RolandWa/logicanalyzer/(list of files, cad)

Other CAD files:
Electronics/LogicAnalyzer/LogicAnalyzer_Roland/1591ATBU.dwg
