RolandWa/logicanalyzer/Electronics/LogicAnalyzer/LogicAnalyzer_Roland/LogicAnalyzer_Roland.kicad_pcb

## KiCad design Electronics/LogicAnalyzer/LogicAnalyzer_Roland/LogicAnalyzer_Roland.kicad_pcb (2025-03-13)

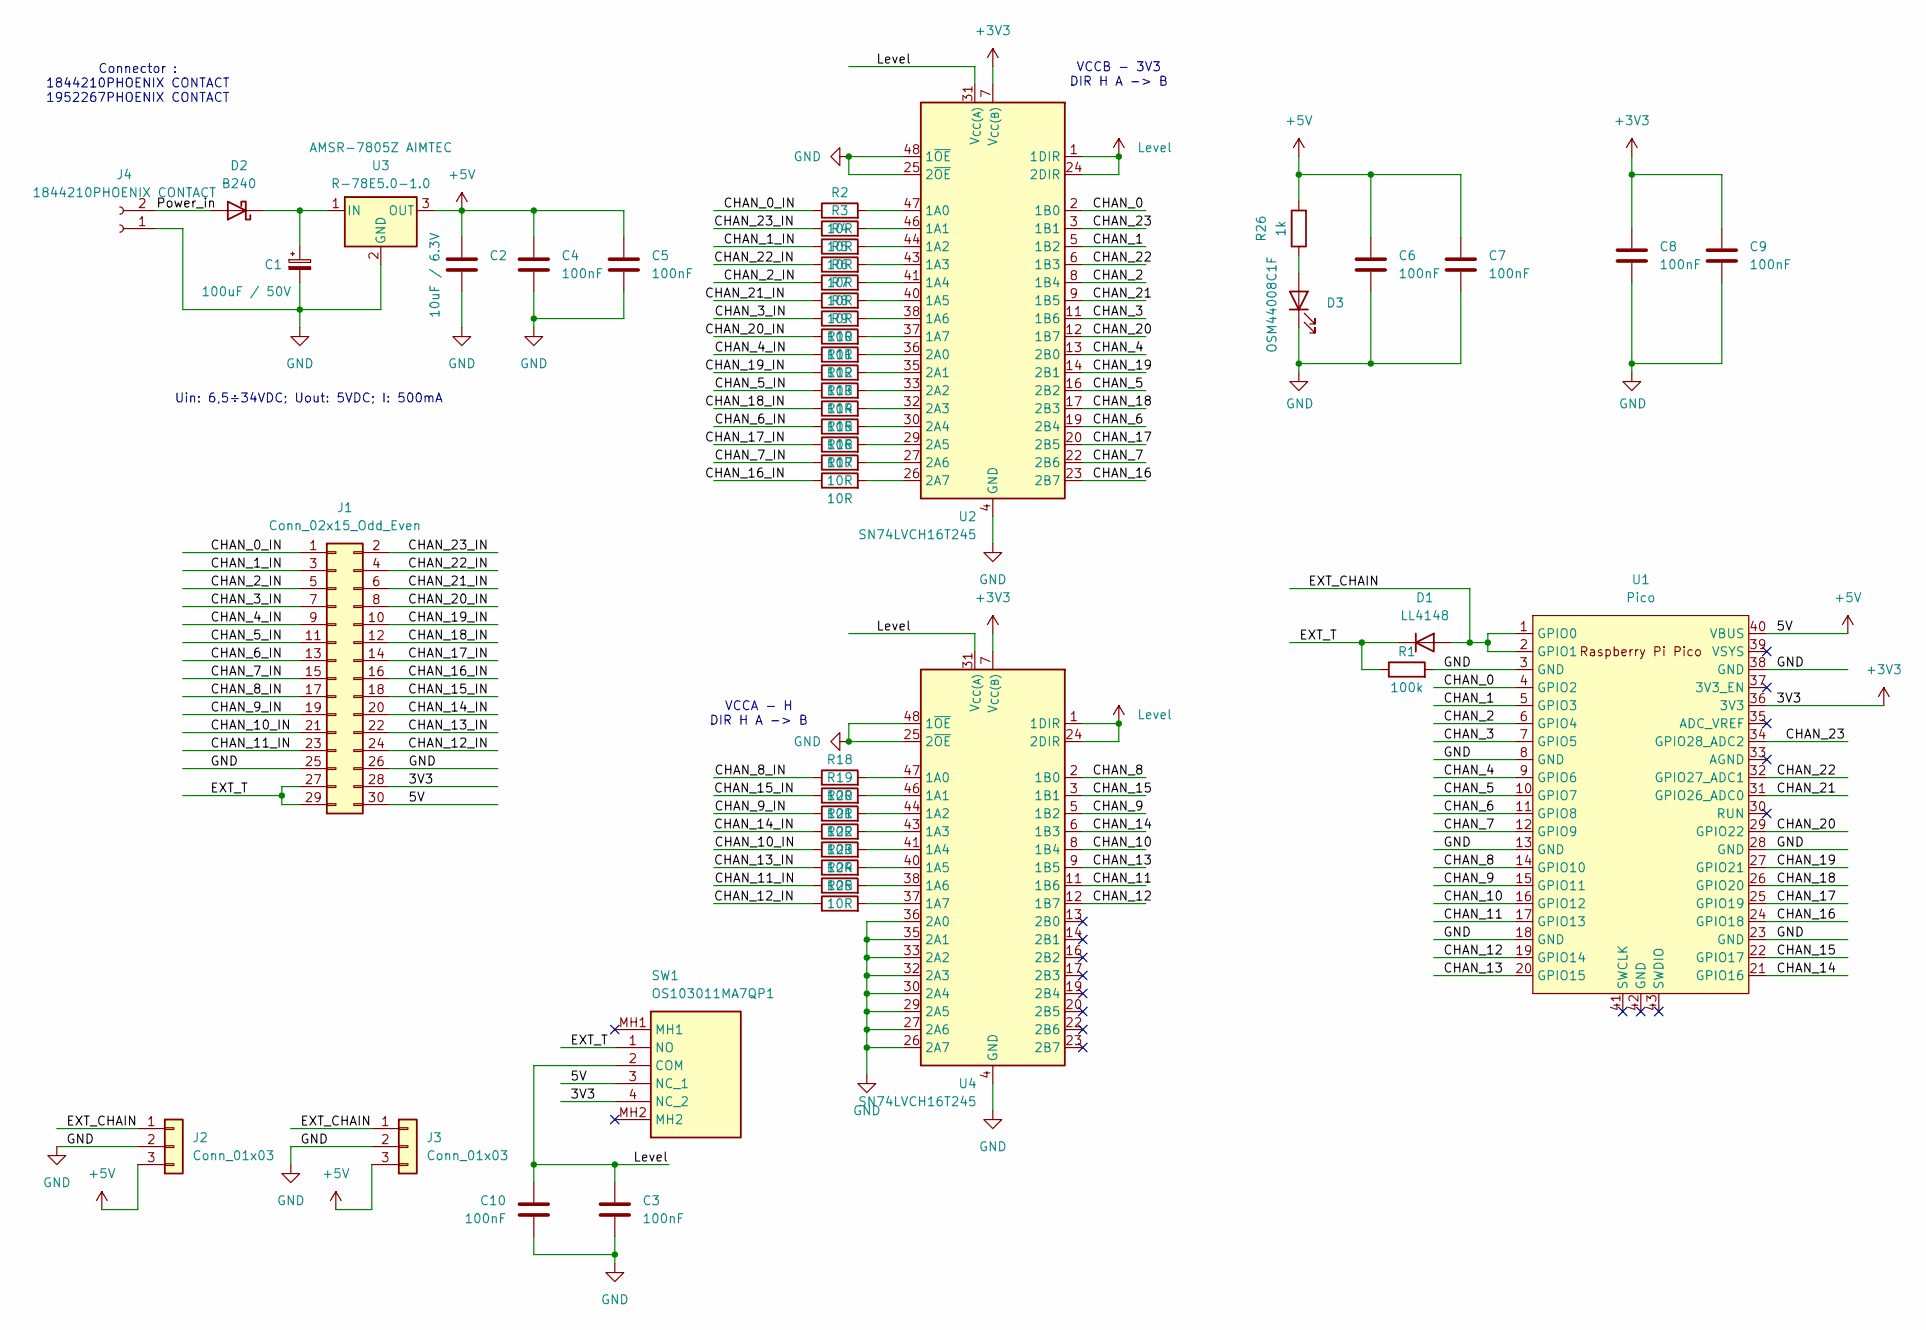
[picture p1: schematic LogicAnalyzer_Roland.kicad_sch, LogicAnalyzer: A 24 channel 100Msps logic analyzer.]

Parts:
C1: 100uF / 50V; CP_Radial_D8.0mm_P3.50mm
C2: 10uF / 6.3V; C_0805_2012Metric
C3, C4, C5, C6, C7, C8, C9, C10: 100nF; C_0603_1608Metric
D1: LL4148; D_MiniMELF
D2: B240; D_SMB
D3: OSM44008C1F; LED_OptoSupply_OSXX4008C1F_4x1.4mm_Horizontal
J1: Conn_02x15_Odd_Even; PinSocket_2x15_P2.54mm_Horizontal
J2: Conn_01x03; PinSocket_1x03_P2.54mm_Horizontal
J3: Conn_01x03; PinHeader_1x03_P2.54mm_Horizontal
J4: 1844210PHOENIX CONTACT; PhoenixContact_MC_1,5_2-G-3.5_1x02_P3.50mm_Horizontal
R1: 100k; R_0402_1005Metric
R2, R3, R4, R5, R6, R7, R8, R9, R10, R11, R12, R13, R14, R15, R16, R17, R18, R19, R20, R21, R22, R23, R24, R25: 10R; R_0402_1005Metric
R26: 1k; R_0402_1005Metric
SW1: OS103011MA7QP1; Manufacturer_Part_Number OS103011MA7QP1; Mouser Part Number 611-OS103011MA7QP1
U1: Pico; RPi_Pico_SMD_TH
U2, U4: SN74LVCH16T245; TSSOP-48_6.1x12.5mm_P0.5mm
U3: R-78E5.0-1.0; Converter_DCDC_RECOM_R-78E-0.5_THT

Connections:
+3V3: C8.1, C9.1, J1.28, SW1.4 (NC_2), U1.36 (3V3), U2.7 (V_{CC(B)}), U2.18 (V_{CC(B)}), U4.7 (V_{CC(B)}), U4.18 (V_{CC(B)})
+5V: C2.1, C4.1, C5.1, C6.1, C7.1, J1.30, J2.3, J3.3, R26.2, SW1.3 (NC_1), U1.40 (VBUS), U3.3 (OUT)
/CHAN_0: U1.4 (GPIO2), U2.2 (1B0)
/CHAN_0_IN: J1.1, R2.1
/CHAN_1: U1.5 (GPIO3), U2.5 (1B2)
/CHAN_1_IN: J1.3, R4.1
/CHAN_2: U1.6 (GPIO4), U2.8 (1B4)
/CHAN_2_IN: J1.5, R6.1
/CHAN_3: U1.7 (GPIO5), U2.11 (1B6)
/CHAN_3_IN: J1.7, R8.1
/CHAN_4: U1.9 (GPIO6), U2.13 (2B0)
/CHAN_4_IN: J1.9, R10.1
/CHAN_5: U1.10 (GPIO7), U2.16 (2B2)
/CHAN_5_IN: J1.11, R12.1
/CHAN_6: U1.11 (GPIO8), U2.19 (2B4)
/CHAN_6_IN: J1.13, R14.1
/CHAN_7: U1.12 (GPIO9), U2.22 (2B6)
/CHAN_7_IN: J1.15, R16.1
/CHAN_8: U1.14 (GPIO10), U4.2 (1B0)
/CHAN_8_IN: J1.17, R18.1
/CHAN_9: U1.15 (GPIO11), U4.5 (1B2)
/CHAN_9_IN: J1.19, R20.1
/CHAN_10: U1.16 (GPIO12), U4.8 (1B4)
/CHAN_10_IN: J1.21, R22.1
/CHAN_11: U1.17 (GPIO13), U4.11 (1B6)
/CHAN_11_IN: J1.23, R24.1
/CHAN_12: U1.19 (GPIO14), U4.12 (1B7)
/CHAN_12_IN: J1.24, R25.1
/CHAN_13: U1.20 (GPIO15), U4.9 (1B5)
/CHAN_13_IN: J1.22, R23.1
/CHAN_14: U1.21 (GPIO16), U4.6 (1B3)
/CHAN_14_IN: J1.20, R21.1
/CHAN_15: U1.22 (GPIO17), U4.3 (1B1)
/CHAN_15_IN: J1.18, R19.1
/CHAN_16: U1.24 (GPIO18), U2.23 (2B7)
/CHAN_16_IN: J1.16, R17.1
/CHAN_17: U1.25 (GPIO19), U2.20 (2B5)
/CHAN_17_IN: J1.14, R15.1
/CHAN_18: U1.26 (GPIO20), U2.17 (2B3)
/CHAN_18_IN: J1.12, R13.1
/CHAN_19: U1.27 (GPIO21), U2.14 (2B1)
/CHAN_19_IN: J1.10, R11.1
/CHAN_20: U1.29 (GPIO22), U2.12 (1B7)
/CHAN_20_IN: J1.8, R9.1
/CHAN_21: U1.31 (GPIO26_ADC0), U2.9 (1B5)
/CHAN_21_IN: J1.6, R7.1
/CHAN_22: U1.32 (GPIO27_ADC1), U2.6 (1B3)
/CHAN_22_IN: J1.4, R5.1
/CHAN_23: U1.34 (GPIO28_ADC2), U2.3 (1B1)
/CHAN_23_IN: J1.2, R3.1
/EXT_CHAIN: D1.2 (A), J2.1, J3.1, U1.1 (GPIO0), U1.2 (GPIO1)
/EXT_T: D1.1 (K), J1.27, J1.29, R1.1, SW1.1 (NO)
/Power_in: D2.2 (A), J4.2
GND: C1.2, C2.2, C3.2, C4.2, C5.2, C6.2, C7.2, C8.2, C9.2, C10.2, D3.1 (K), J1.25, J1.26, J2.2, J3.2, J4.1, R1.2, U1.3 (GND), U1.8 (GND), U1.13 (GND), U1.18 (GND), U1.23 (GND), U1.28 (GND), U1.38 (GND), U2.4 (GND), U2.10 (GND), U2.15 (GND), U2.21 (GND), U2.25 (2~OE), U2.28 (GND), U2.34 (GND), U2.39 (GND), U2.45 (GND), U2.48 (1~OE), U3.2 (GND), U4.4 (GND), U4.10 (GND), U4.15 (GND), U4.21 (GND), U4.25 (2~OE), U4.26 (2A7), U4.27 (2A6), U4.28 (GND), U4.29 (2A5), U4.30 (2A4), U4.32 (2A3), U4.33 (2A2), U4.34 (GND), U4.35 (2A1), U4.36 (2A0), U4.39 (GND), U4.45 (GND), U4.48 (1~OE)
Level: C3.1, C10.1, SW1.2 (COM), U2.1 (1DIR), U2.24 (2DIR), U2.31 (V_{CC(A)}), U2.42 (V_{CC(A)}), U4.1 (1DIR), U4.24 (2DIR), U4.31 (V_{CC(A)}), U4.42 (V_{CC(A)})
unnamed: C1.1, D2.1 (K), U3.1 (IN)
unnamed: D3.2 (A), R26.1
unnamed: R2.2, U2.47 (1A0)
unnamed: R3.2, U2.46 (1A1)
unnamed: R4.2, U2.44 (1A2)
unnamed: R5.2, U2.43 (1A3)
unnamed: R6.2, U2.41 (1A4)
unnamed: R7.2, U2.40 (1A5)
unnamed: R8.2, U2.38 (1A6)
unnamed: R9.2, U2.37 (1A7)
unnamed: R10.2, U2.36 (2A0)
unnamed: R11.2, U2.35 (2A1)
unnamed: R12.2, U2.33 (2A2)
unnamed: R13.2, U2.32 (2A3)
unnamed: R14.2, U2.30 (2A4)
unnamed: R15.2, U2.29 (2A5)
unnamed: R16.2, U2.27 (2A6)
unnamed: R17.2, U2.26 (2A7)
unnamed: R18.2, U4.47 (1A0)
unnamed: R19.2, U4.46 (1A1)
unnamed: R20.2, U4.44 (1A2)
unnamed: R21.2, U4.43 (1A3)
unnamed: R22.2, U4.41 (1A4)
unnamed: R23.2, U4.40 (1A5)
unnamed: R24.2, U4.38 (1A6)
unnamed: R25.2, U4.37 (1A7)

Notes on the sheet:
VCCB - 3V3 DIR H A -> B
Connector : 1844210PHOENIX CONTACT 1952267PHOENIX CONTACT
Uin: 6,5÷34VDC; Uout: 5VDC; I: 500mA
VCCA - H DIR H A -> B

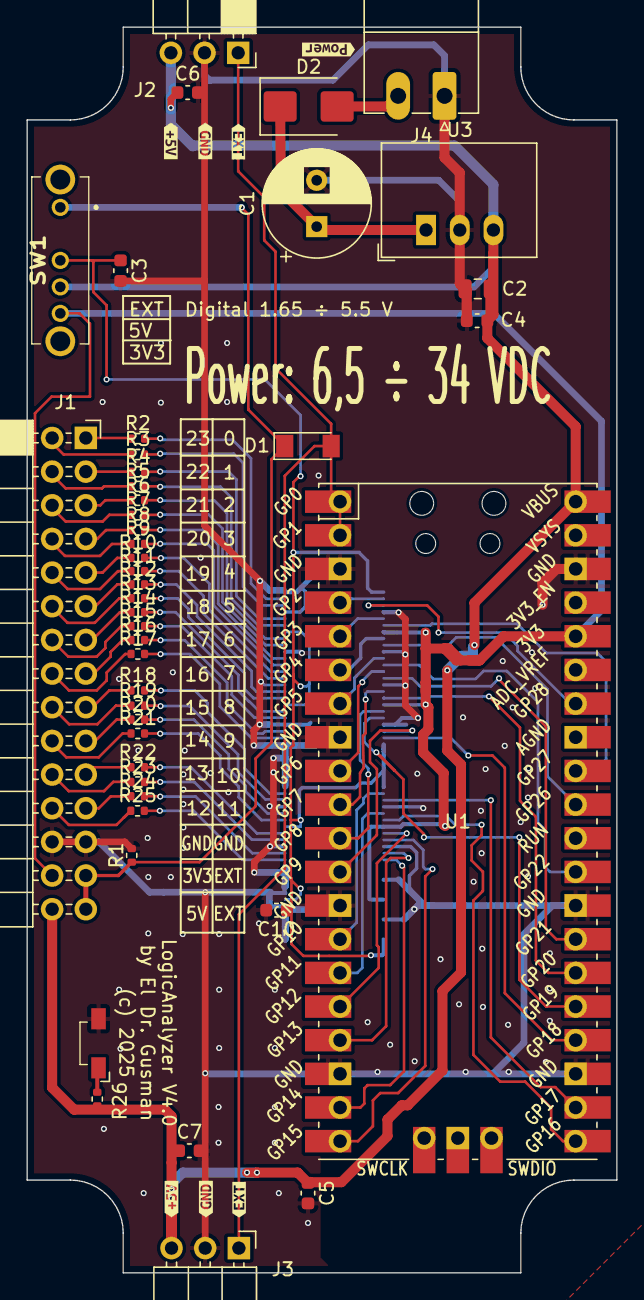
[picture p2: board LogicAnalyzer_Roland.kicad_pcb from above]

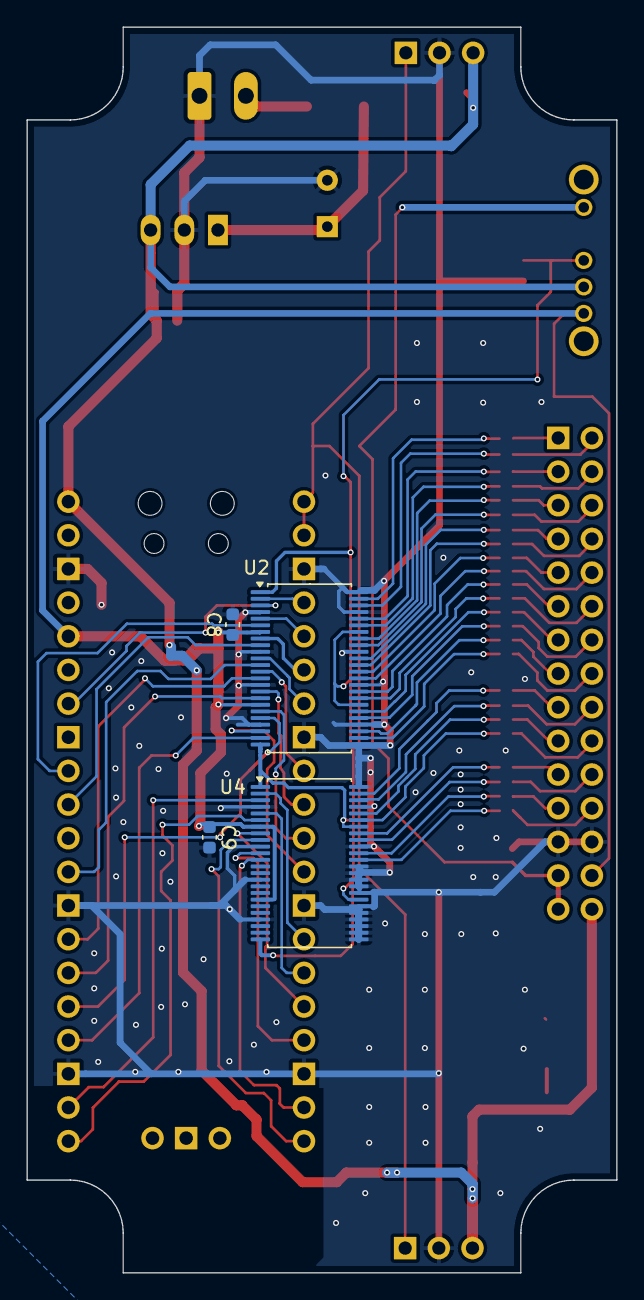
[picture p3: board LogicAnalyzer_Roland.kicad_pcb from below]

Board: 2 copper layers, 44.5 x 94.0 mm, 55 parts (4 on the bottom side), 81 nets.

Other parts of the board:
kibuzzard-679CD50C, kibuzzard-679CD50C#2: G***; kibuzzard-679CD50C
kibuzzard-679CD538, kibuzzard-679CD538#2: G***; kibuzzard-679CD538
kibuzzard-679CD548, kibuzzard-679CD548#2: G***; kibuzzard-679CD548
kibuzzard-679CD658: G***; kibuzzard-679CD658
