RolandWa/logicanalyzer/(notices)

Notices in the files:
Electronics/LogicAnalyzer/LogicAnalyzer_Roland/LogicAnalyzer_Roland.kicad_pcb:
(c) 2025
